bwack/VideoPac-RAMCart/README.md

# VideoPac-RAMCart
The RAMCart made by Soeren Gust in 1999 and found in the internet archives
