bwack/VideoPac-RAMCart/G7000.jpg

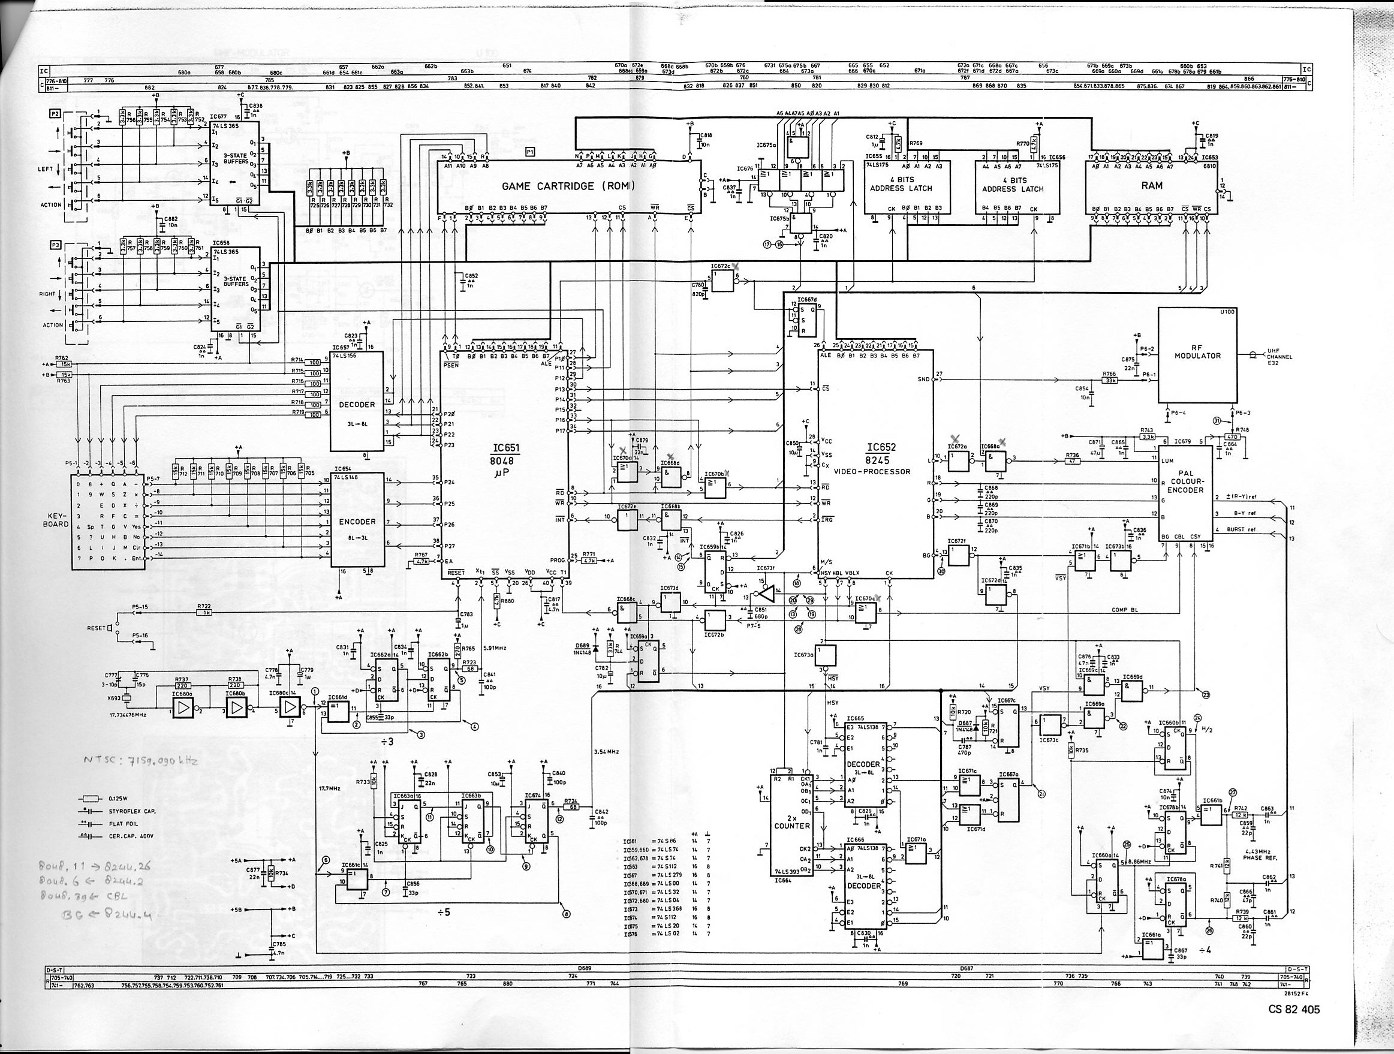
G7000.jpg
