bwack/VideoPac-RAMCart/G7000_1.jpg

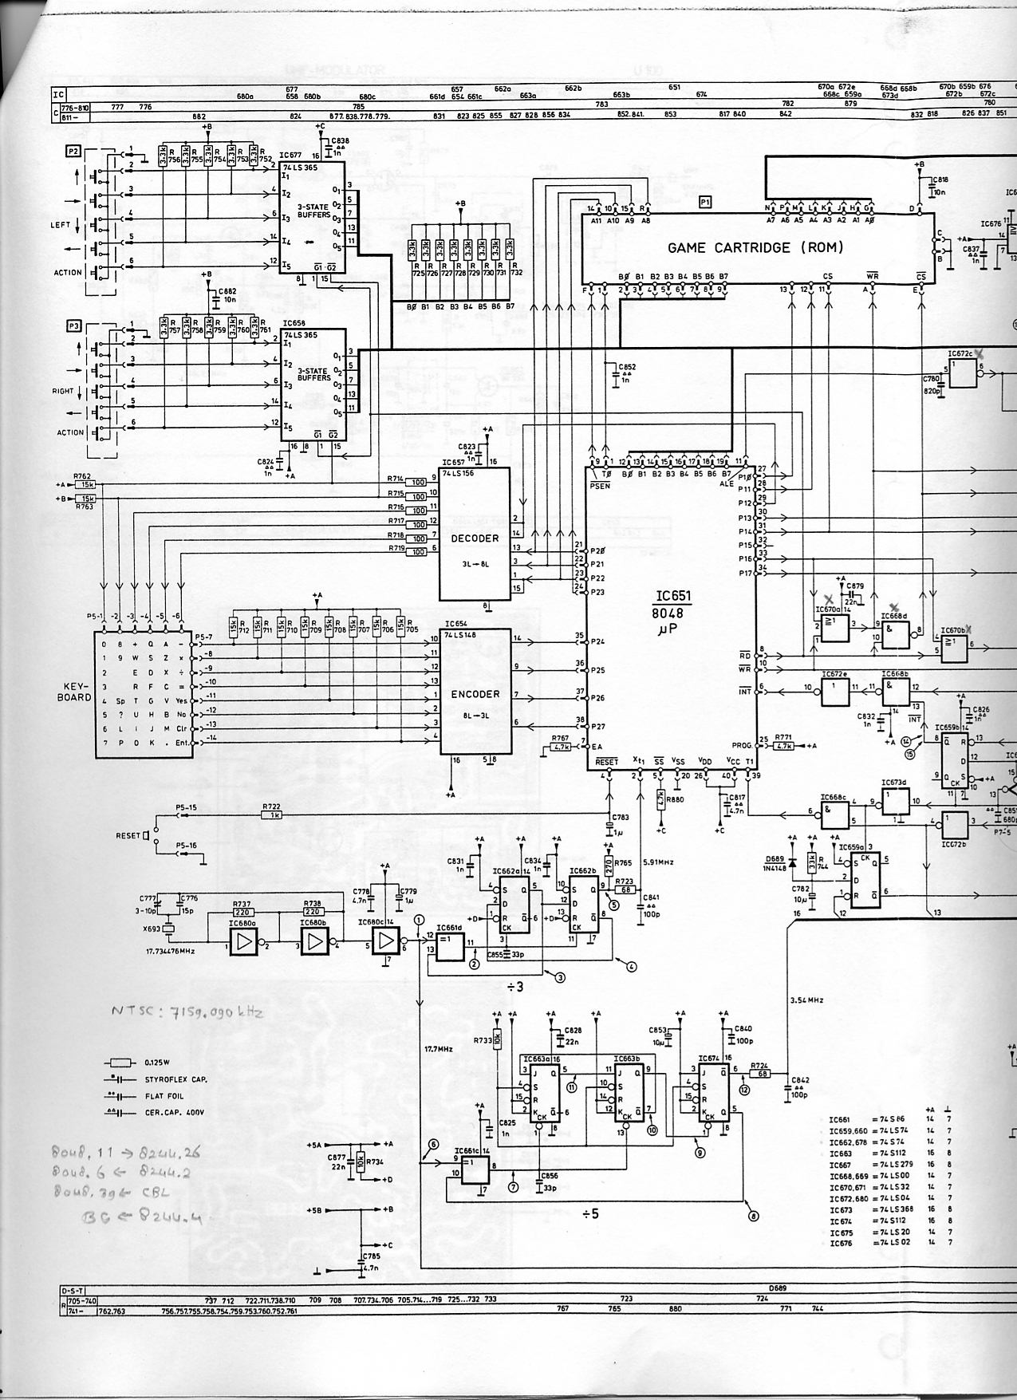
G7000_1.jpg
