bwack/VideoPac-RAMCart/G7000_2.jpg

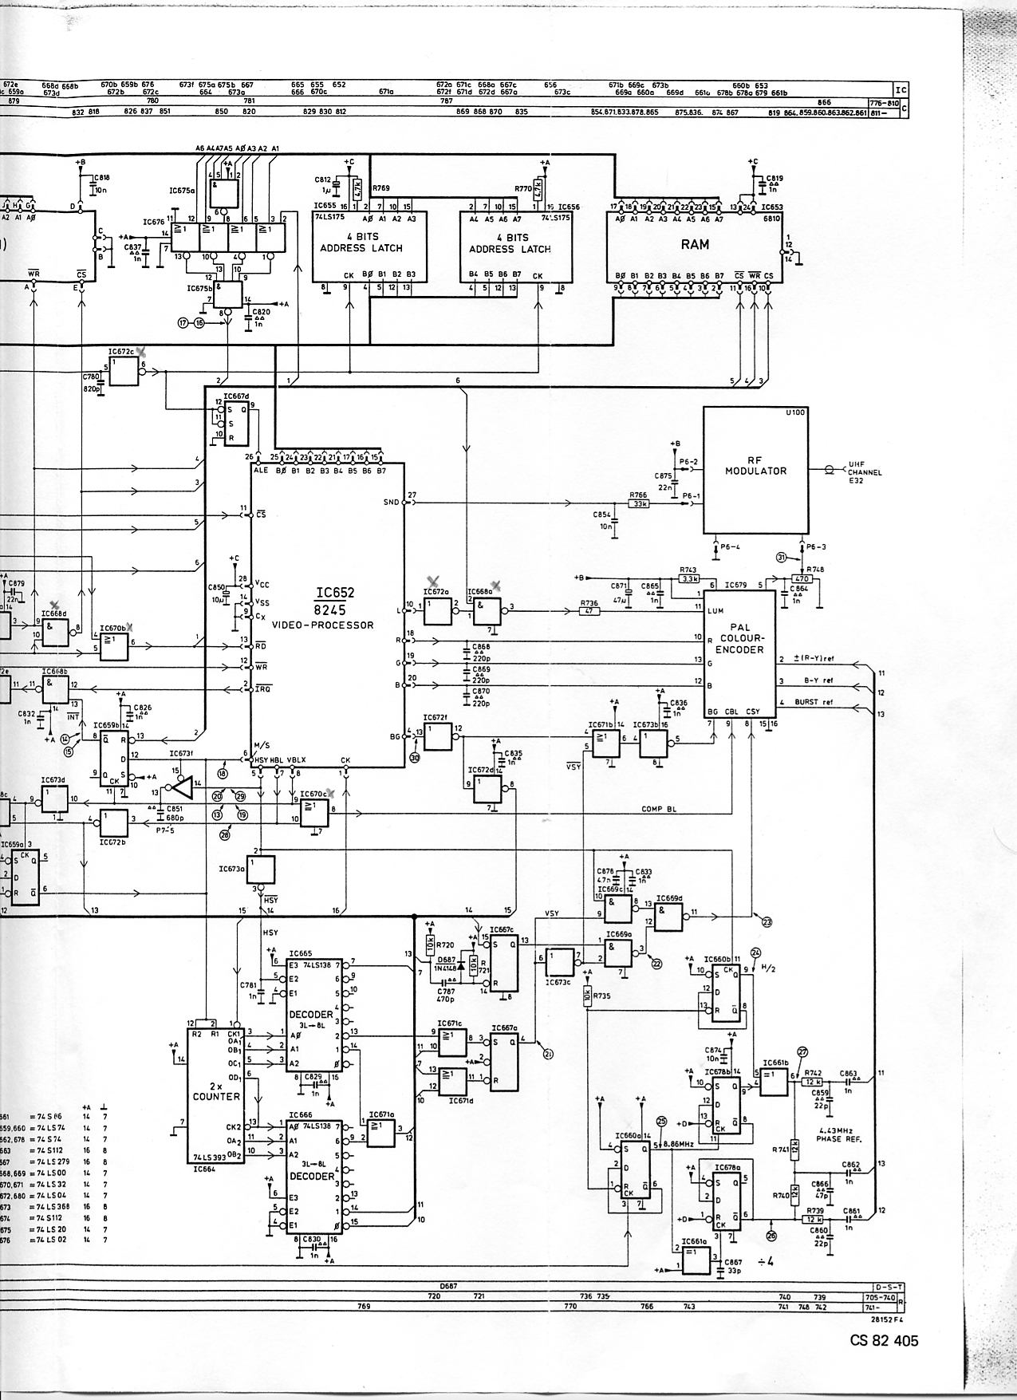
G7000_2.jpg
