bwack/VideoPac-RAMCart/g7000ram-1.5/png300/g7000com.png

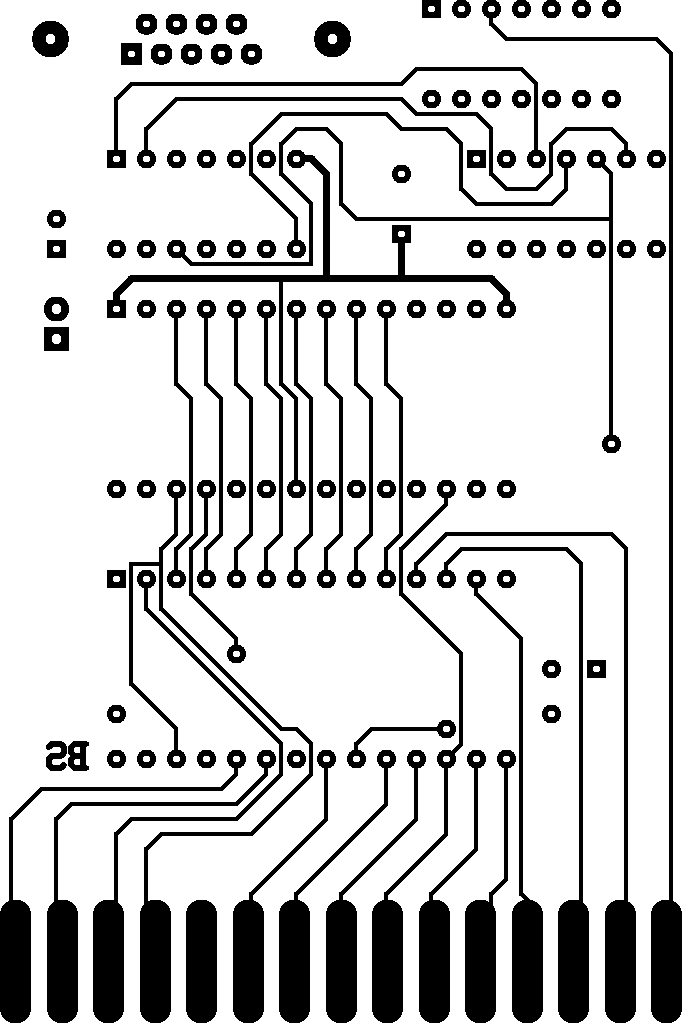
g7000ram-1.5/png300/g7000com.png
