bwack/VideoPac-RAMCart/(list of files, cad)

Other CAD files:
g7000ram-1.5/example/hello.obj
