bwack/VideoPac-RAMCart/g7000ram-1.5/schematic.pdf

# Version 1.1

# http://soeren.informationstheater.de

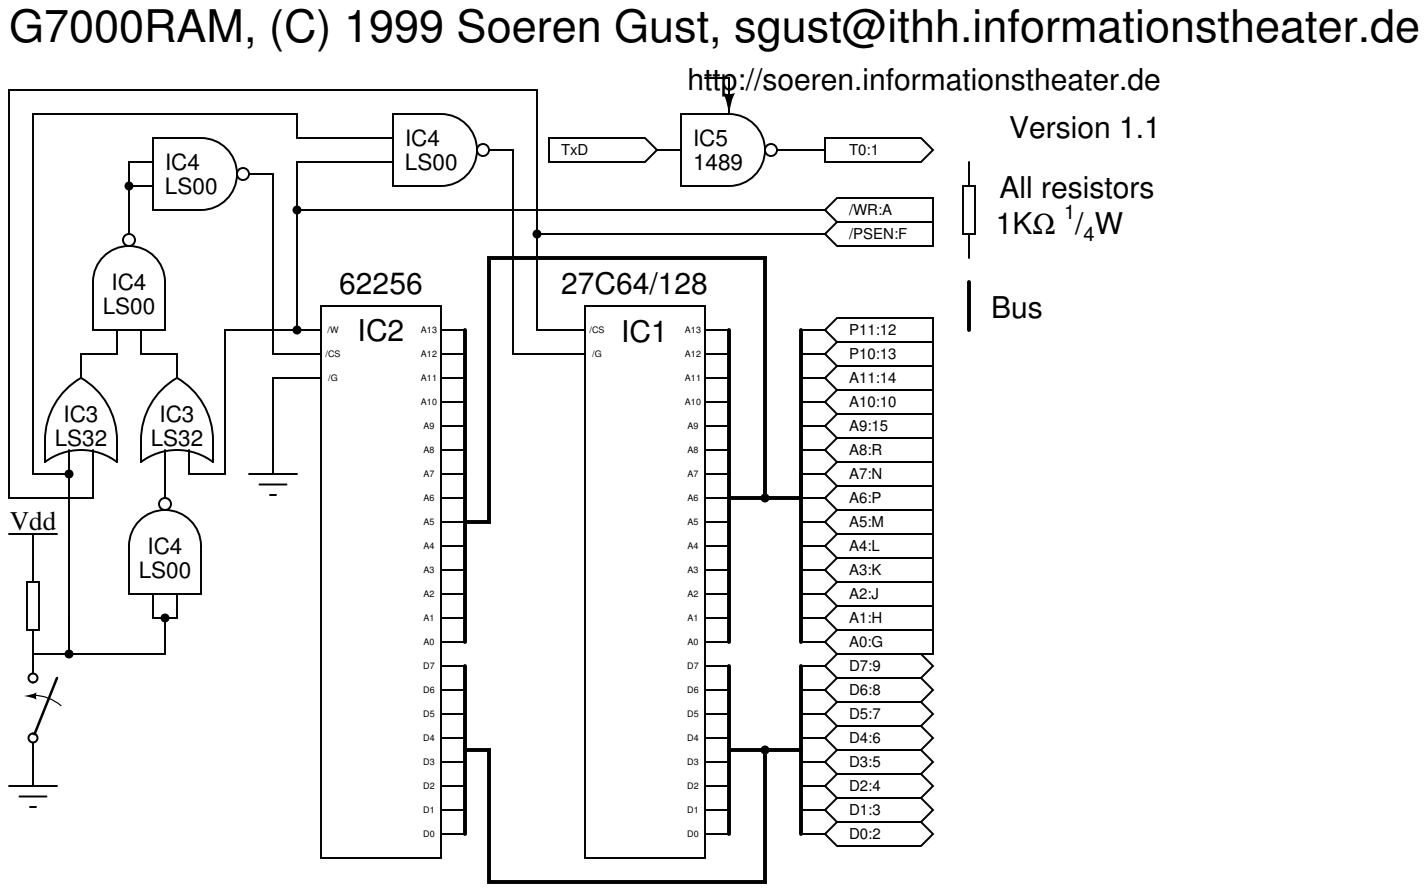
[picture p7: page 1]

G7000RAM, (C) 1999 Soeren Gust, sgust@ithh.informationstheater.de
